Tinkerforge/moisture-bricklet/software/examples/labview/Example Callback.vi.png

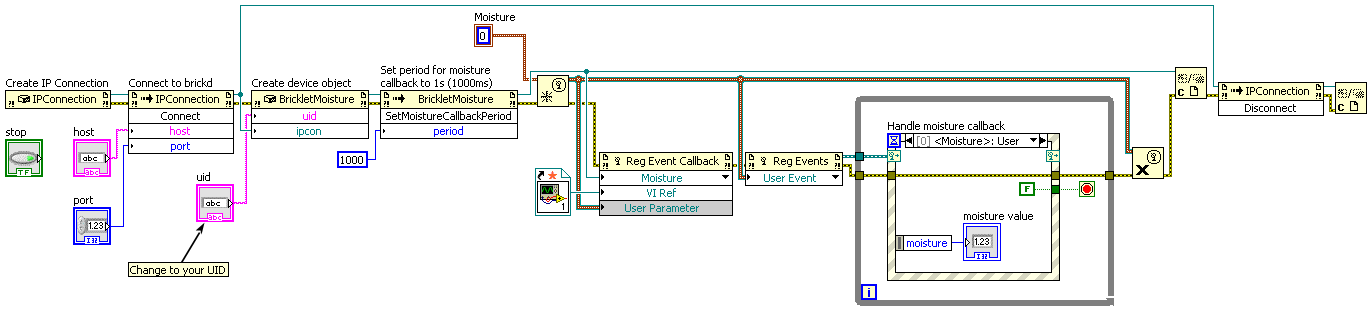
software/examples/labview/Example Callback.vi.png
