Tinkerforge/moisture-bricklet/software/examples/labview/Example Graph.vi.png

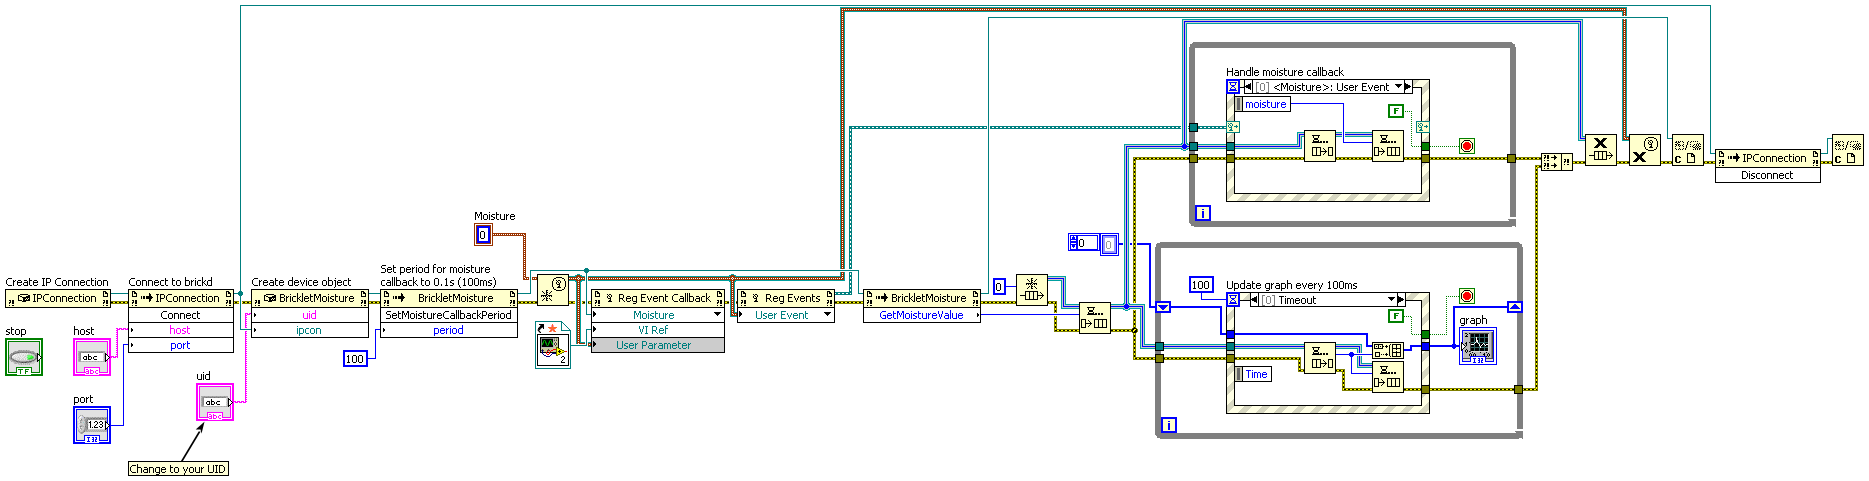
software/examples/labview/Example Graph.vi.png
