Tinkerforge/moisture-bricklet/software/examples/labview/Example Threshold.vi.png

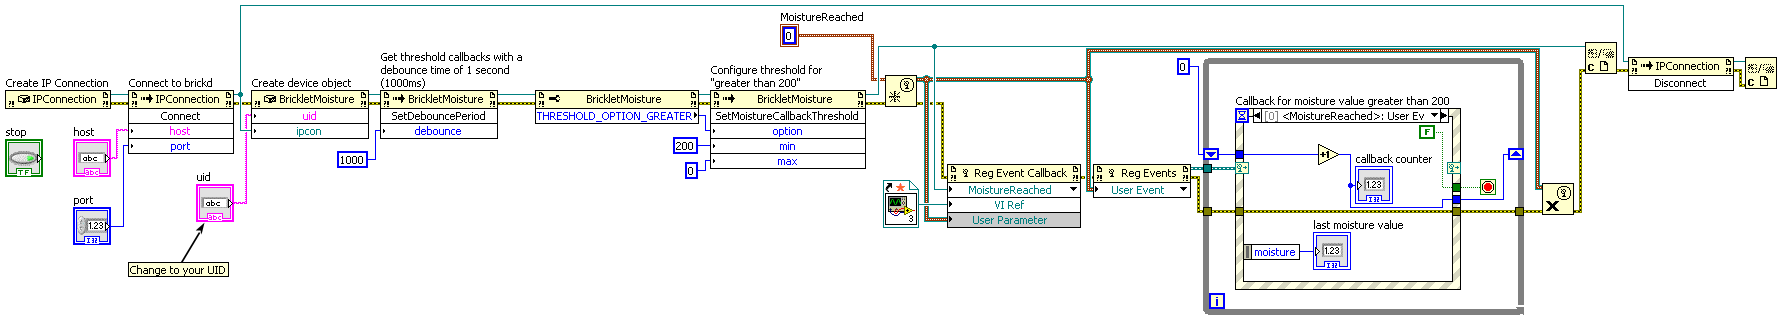
software/examples/labview/Example Threshold.vi.png
