Tinkerforge/moisture-bricklet/hardware/moisture.step

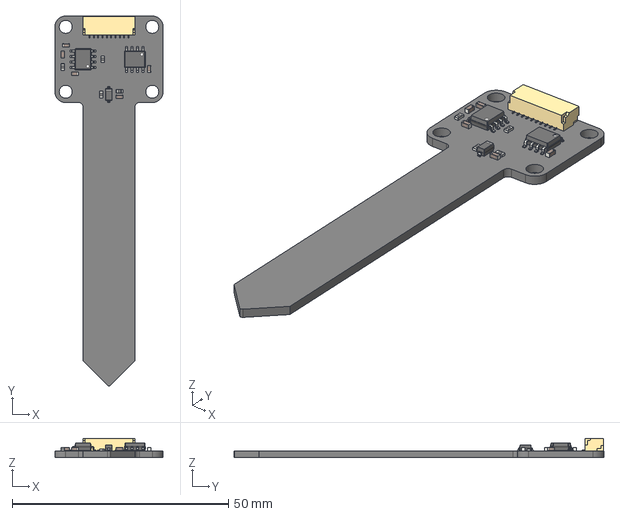
[picture p5: CAD file, 2017-08-01]
hardware/moisture.step
25.0 x 85.5 x 4.50 mm
