Tinkerforge/moisture-bricklet/(list of files, cad)

Other CAD files:
hardware/moisture.FCStd
