Tinkerforge/moisture-bricklet/hardware/moisture-schematic.pdf

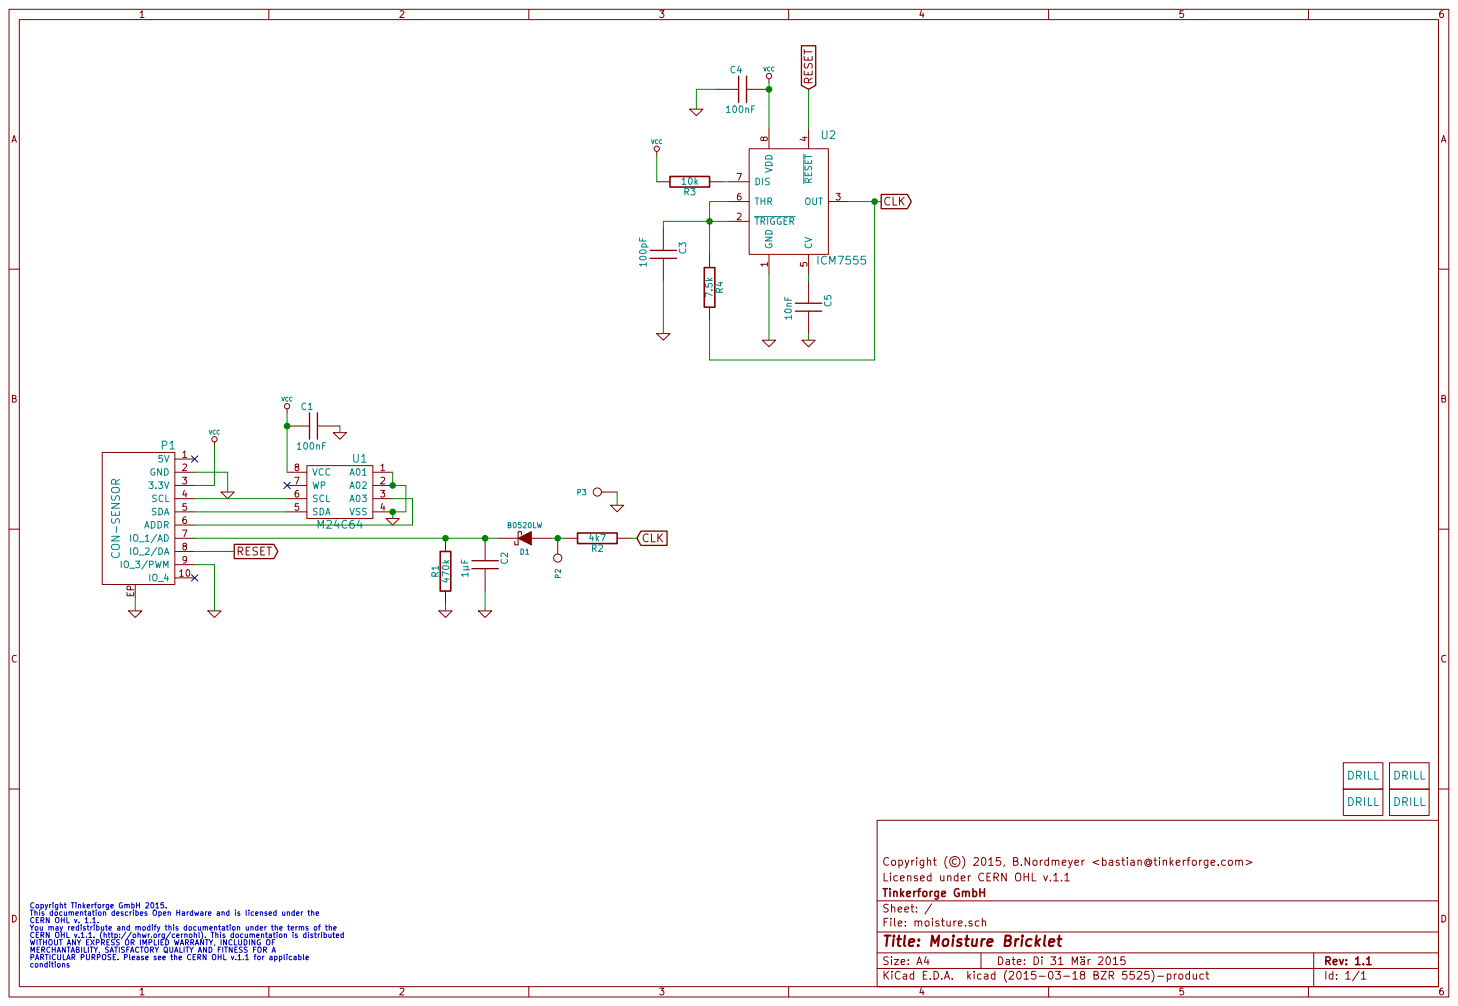
[picture p6: page 1]

VCC Copyright Tinkerforge GmbH 2015. This documentation describes Open Hardware and is licensed under the CERN OHL v. 1.1. You may redistribute and modify this documentation under the terms of the CERN OHL v.1.1. (http://ohwr.org/cernohl). This documentation is distributed WITHOUT ANY EXPRESS OR IMPLIED WARRANTY, INCLUDING OF MERCHANTABILITY, SATISFACTORY QUALITY AND FITNESS FOR A

Licensed under CERN OHL v.1.1 Copyright (©) 2015, B.Nordmeyer <bastian@tinkerforge.com>

Id: 1/1 Title: Moisture Bricklet File: moisture.sch Sheet: / Tinkerforge GmbH

PARTICULAR PURPOSE. Please see the CERN OHL v.1.1 for applicable
