Tinkerforge/moisture-bricklet/hardware/moisture.kicad_pcb

## KiCad design hardware/moisture.kicad_pcb (2017-08-01)

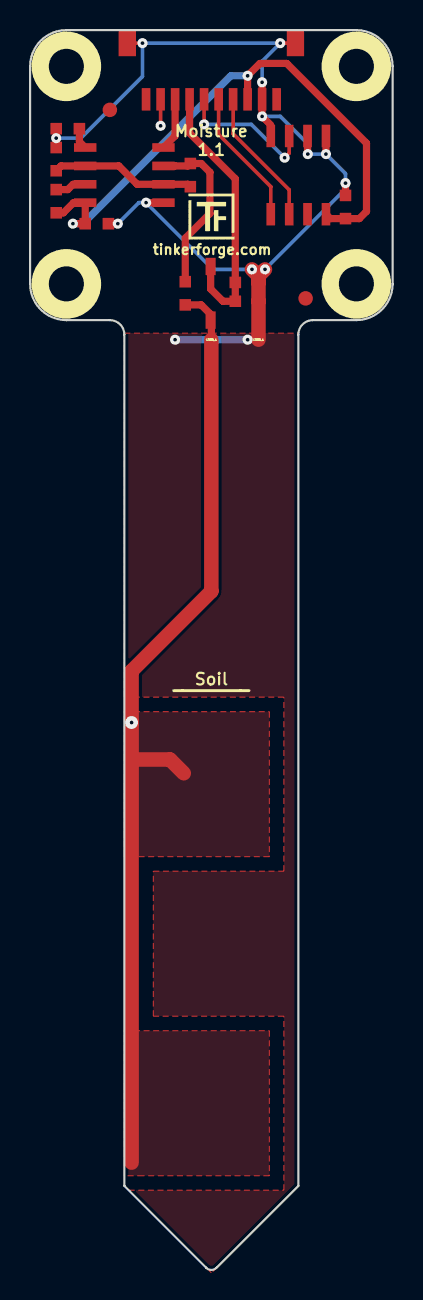
[picture p7: board moisture.kicad_pcb from above]

Board: 2 copper layers, 25.0 x 85.5 mm, 23 parts (2 on the bottom side), 12 nets.

Parts:
C1, C4: 100nF; C0603
C2: 1µF; C0603
C3: 100pF; C0603
C5: 10nF; C0603
D1: B0520LW; SOD-123
Fiducial_Mark: VAL**; Fiducial_Mark
Fiducial_Mark#2: VAL**; Fiducial_Mark
P1: CON-SENSOR
P2, P3: CONN_1; con
R1: 470k; R0603
R2: 4k7; R0603
R3: 10k; R0603
R4: 7.5k; R0603
U1: M24C64; SOIC8
U2: ICM7555; SOIC8
U3, U4, U5, U6: DRILL; DRILL_NP
VAL: CE_5mm
VAL#2: WEEE_7mm

Connections:
CLK: R2.1, R4.2, U2.3
GND: C1.2, C2.2, C3.2, C4.1, C5.2, P1.2, P1.9, P1.EP, P3.1, R1.1, U1.1, U1.2, U1.4, U2.1
unnamed: C2.1, D1.2, P1.7, R1.2
unnamed: C3.1, R4.1, U2.2, U2.6
unnamed: C5.1, U2.5
unnamed: D1.1, P2.1, R2.2
unnamed: P1.4, U1.6
unnamed: P1.5, U1.5
unnamed: P1.6, U1.3
unnamed: R3.1, U2.7
RESET: P1.8, U2.4
VCC: C1.1, C4.2, P1.3, R3.2, U1.8, U2.8
