Tinkerforge/moisture-bricklet/software/src/config.h

/* moisture-bricklet
 * Copyright (C) 2013 Olaf Lüke <olaf@tinkerforge.com>
 *
 * config.h: Moisture Bricklet specific configuration
 *
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
 * You should have received a copy of the GNU Lesser General Public
 * License along with this library; if not, write to the
 * Free Software Foundation, Inc., 59 Temple Place - Suite 330,
 * Boston, MA 02111-1307, USA.
 */

#ifndef CONFIG_H
#define CONFIG_H

#include <stdint.h>
#include <stdbool.h>

#include "bricklib/drivers/board/sam3s/SAM3S.h"

#include "moisture.h"

#define BRICKLET_FIRMWARE_VERSION_MAJOR 2
#define BRICKLET_FIRMWARE_VERSION_MINOR 0
#define BRICKLET_FIRMWARE_VERSION_REVISION 1

#define BRICKLET_HARDWARE_VERSION_MAJOR 1
#define BRICKLET_HARDWARE_VERSION_MINOR 0
#define BRICKLET_HARDWARE_VERSION_REVISION 0

#define BRICKLET_DEVICE_IDENTIFIER 232

#define PIN_AD_MOISTURE (BS->pin1_ad)
#define PIN_SW_ON_OFF (BS->pin2_da)
#define PIN_PW_ON_OFF (BS->pin3_pwm)

#define LOGGING_LEVEL LOGGING_DEBUG
#define DEBUG_BRICKLET 0

#define BRICKLET_HAS_SIMPLE_SENSOR
#define BRICKLET_NO_OFFSET
#define INVOCATION_IN_BRICKLET_CODE
#define SIMPLE_VALUE_TYPE uint16_t
#define NUM_SIMPLE_VALUES 1
#define BOARD_MCK 64000000

typedef struct {
	int32_t value[NUM_SIMPLE_VALUES];
	int32_t last_value[NUM_SIMPLE_VALUES];

	uint32_t signal_period[NUM_SIMPLE_VALUES];
	uint32_t signal_period_counter[NUM_SIMPLE_VALUES];

	uint32_t threshold_debounce;
	uint32_t threshold_period_current[NUM_SIMPLE_VALUES];
	int32_t threshold_min[NUM_SIMPLE_VALUES];
	int32_t threshold_max[NUM_SIMPLE_VALUES];

	int32_t threshold_min_save[NUM_SIMPLE_VALUES];
	int32_t threshold_max_save[NUM_SIMPLE_VALUES];

	uint32_t tick;

	uint32_t moving_average_sum;
	uint16_t moving_average[MOVING_AVERAGE_MAX];

	char threshold_option_save[NUM_SIMPLE_VALUES];
	char threshold_option[NUM_SIMPLE_VALUES];
	uint8_t moving_average_num;
	uint8_t moving_average_tick;
} BrickContext;

#endif
