Tinkerforge/moisture-bricklet/(commit log)

2013-09-13 Simplify switch
2013-10-15 add hardware files
    [moisture.kicad_pcb, moisture.sch]
2013-11-21 Avoid division by zero in average calculation
    [moisture.c]
2013-12-19 Fix wrong length for GetDebounce packet (through brickletlib)
    [config.h]
2014-04-02 perl: Unify print style
2015-03-26 checkin of prototype files
    [moisture.kicad_pcb, moisture.sch]
2015-03-31 two new prototypes for moisture bricklet (oportunities)
    [moisture.kicad_pcb, moisture.sch]
2015-04-02 add fiducials
    [moisture.kicad_pcb]
2015-04-02 change labels, drc
    [moisture.kicad_pcb]
2015-04-07 remove wrong masks
    [moisture.kicad_pcb]
2015-04-08 update vias to standard size 0.7mm, 0.25mm
    [moisture.kicad_pcb]
2015-04-24 adapt values, change to astable operation (figure 1a in icm7555 datasheet)
    [moisture.kicad_pcb, moisture.sch]
2015-04-24 drc executed
    [moisture.kicad_pcb]
2015-04-24 fix logo position
    [moisture.kicad_pcb]
2015-05-04 connect pin3 to ground
    [moisture.kicad_pcb, moisture.sch]
2015-08-01 remove not used prototypes, move to new hardware version
    [moisture.kicad_pcb, moisture.sch]
2015-08-03 update schematic
2015-08-07 Use full device class name in Python examples
2015-08-13 Use correct simple value type
    [config.h]
2015-08-21 Use shorter print statement in Perl example
2016-05-18 c: Add missing device destroy call
2017-08-01 Add 3d information (final)
    [moisture.kicad_pcb, moisture.sch]
2017-08-01 Add 3d model (*.step & *.FCStd)
    [moisture.FCStd, moisture.step]
2018-01-26 c: Fine-tune printf format
2018-02-20 Cleanup KiCad libraries config
    Ensure LibDir=kicad-libraries and LibName1=tinkerforge.
    Remove special library.
2021-10-25 Update KiCad link
    https://www.kicad.org/blog/2021/10/Avoid-links-to-former-kicad-domain/
