Tinkerforge/moisture-bricklet/(notices)

Notices in the files:
hardware/moisture.kicad_pcb:
Copyright (©) 2014, B.Nordmeyer
Copyright Tinkerforge GmbH 2014.
